iamsurya/MPU6000-Datalogger/Readme.md

Masters Thesis project to create a datalogger that tracks and stores 16 hours of wrist motion data in an effort to create algorithms that can detect eating.

See thesis here: http://cecas.clemson.edu/~ahoover/theses/sharma-thesis.pdf
