iamsurya/MPU6000-Datalogger/Thesis and Presentation/DefensePresentation.pdf

# A device to record natural daily wrist motion

## MS Thesis Defense

Surya Prakash Sharma

Committee Members:
Dr. Adam Hoover (Chair)
Dr. Ian Walker
Dr. Jason Hallstrom

November 24, 2014

# Outline

# - Motivation and Background

# - Methods

# - Results

# - Conclusion

# Motivation

## - Our vision: Wrist-worn eating activity monitor - Previous work: 81% accuracy detecting periods of eating (44 subjects, 1 day) 86% accuracy counting bites during eating (49 subjects, 1 meal) - Need: device to record large number of people for long period of time

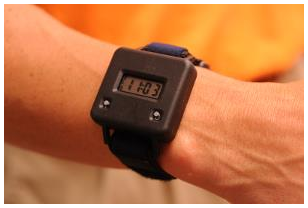
[picture p2: figure]

The bite counter

# Background (cont)

## Recording wrist movement data requires three basic components

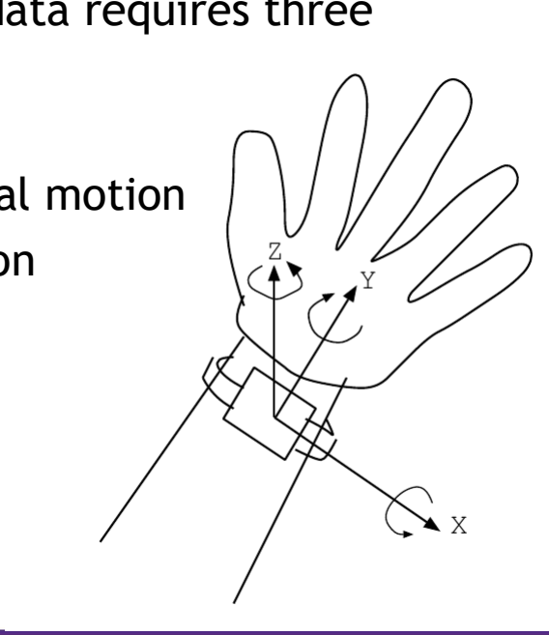
[picture p3: figure]

## Accelerometer – Translational motion Gyroscope – Rotational Motion Memory – Store Data

# Background

## - Multiple wrist worn devices

available.

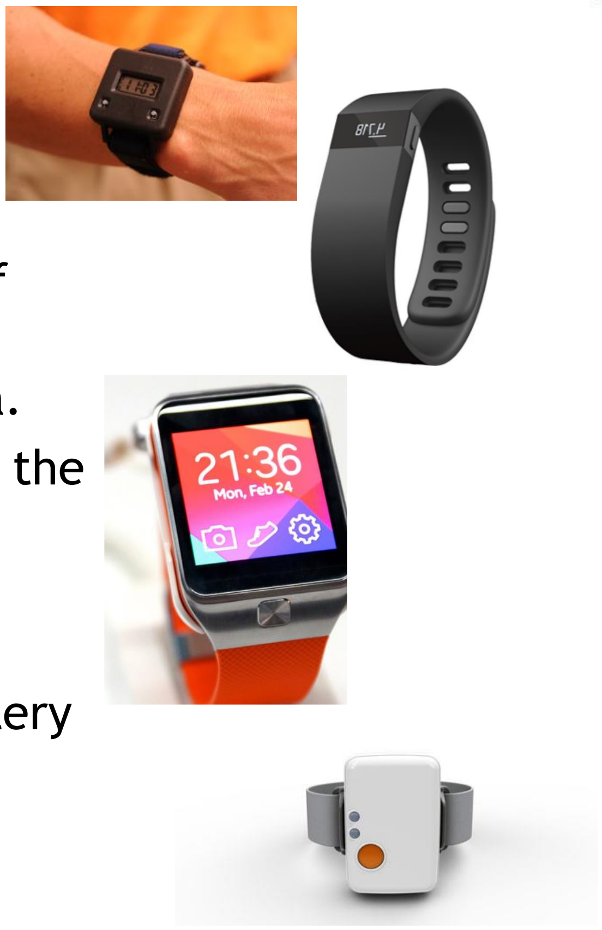
[picture p4: figure]

## - None has addressed the need of recording translational and

rotational wrist movement data.

## - Many devices do not contain all the required sensors - Others have unneeded features increasing cost, weight and discomfort, while reducing battery

life.

# Previous Work

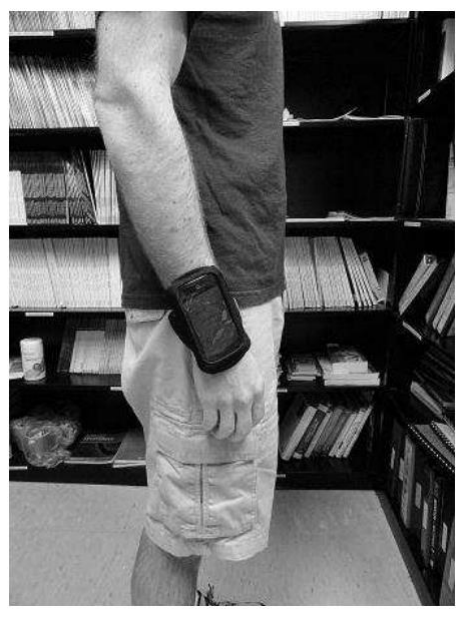
[picture p5: figure]

## - iPhone Based Data Logger

## – Long Battery Life – High resolution data – High customizability

## – Big Size – Low comfort

http://www.ces.clemson.edu/~ahoover/theses/dong-diss.pdf

# Other Devices

## - Activity Trackers

## – Long Battery Life – Small Size – High Comfort – Economical Cost

## – Low resolution data – No customizability – No gyroscope

https://www.flickr.com/photos/uscpsc/13104103473

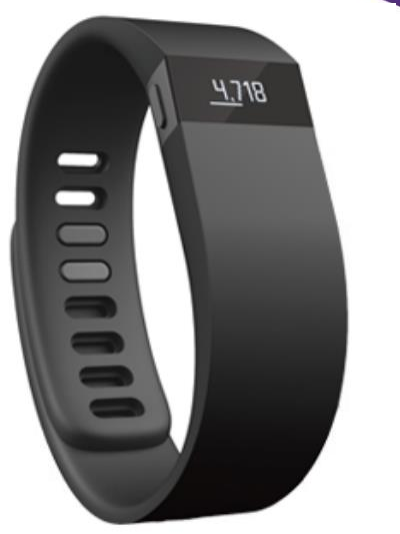
[picture p6: figure]

The Fitbit Flex

# Other Devices (cont)

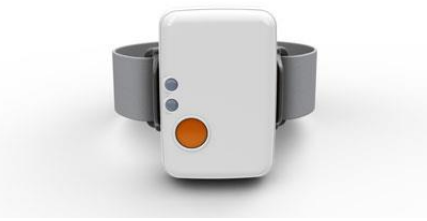
[picture p7: figure]

## - Research Devices

## – Average Battery Life – High resolution Data – High customizability – Medium Comfort

## – High cost – Development Kit: $2000 – Unit : $249

www.shimmersensing.com/shop/shimmer3

Promotional photo of the SHIMMER

# Other Devices (cont)

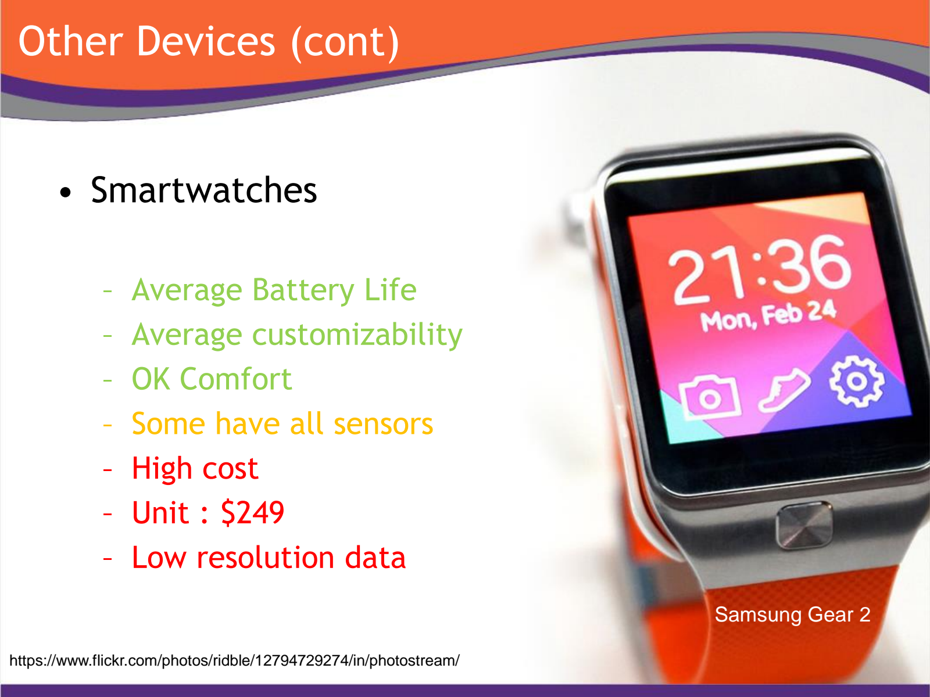
[picture p8: page 9]

## - Smartwatches

## – Average Battery Life – Average customizability – OK Comfort – Some have all sensors – High cost – Unit : $249

## – Low resolution data

https://www.flickr.com/photos/ridble/12794729274/in/photostream/

Samsung Gear 2

# Summary

Name | Market Segments | Both Sensors | Size | Weight (g) | Active Battery Life (hours) | Extra components
iPhone | Mobile Phone | Y | Large | 149 | 40 | Display, GSM Module
MetaWatch | SmartWatch | N | Small | 81 | 80 | Display, Bluetooth Module
Samsung Gear 2 | SmartWatch | Y | Small | 68 | 48 | Display, Bluetooth Module, Media Player
Fitbit Zip | Fitness Tracker | N | Small | 8 | 6 mo
Fitbit Flex | Fitness Tracker | N | Small | N/A | 120
Jawbone Up Move | Fitness Tracker | N | Small | 6.8 | 168
Jawbone Up 3 | Fitness Tracker | N | Small | 29 | 168
Fitbit One | Fitness Tracker | N | Small | 8 | 240
Nike FuelBand | Fitness Tracker | N | Small | 30 | 96
SHIMMER | Research | Y | Medium | 23.6 | 24 | SD Card, Bluetooth Module
Thalmic Labs Myo | Research | Y | Medium | 93 | 48 | EMG Sensors

Note: Sizes are as follows:
Small : Wrist watch or similar
Medium: Larger than wrist watch, smaller than a smartphone. Large: Smartphone

# Novelty

## - New Wrist mounted device to log motion data

## – Good Battery Life – High customizability – Economical Cost – High Comfort

- Smaller size leads to more comfort,

# and the user can wear it longer

# Methods

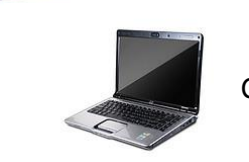
[picture p9: figure]
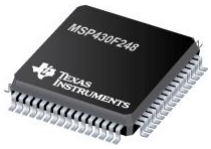
[picture p10: figure]
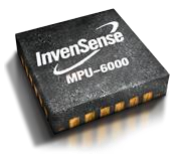
[picture p11: figure]
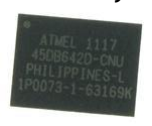
[picture p12: figure]

http://www.ti.com/graphics/folders/partimages/MSP430F248.jpg https://www.flickr.com/photos/40875537@N04/5659910644http://www.snowcap.fi/uploads//2011/12/mpu6000.png (http://www.snowcap.fi/uploads/2011/12/mpu6000.png) http://electronics-diy.com/img/FT232RL_chip.jpghttp://www.mouser.com/images/adestotechnologies/images/cason8.jpg

Sensors

Microcontroller

Memory

USB to UART

Computer

# Components

## •Sensor •Memory chip •Microcontroller •USB to UART bridge •Battery •Battery charger •LED •Button •Case

# Procedure

## •Part selection

## •Circuit design / Prototype / Programming

## •PCB design

## •Soldering

# Sensor

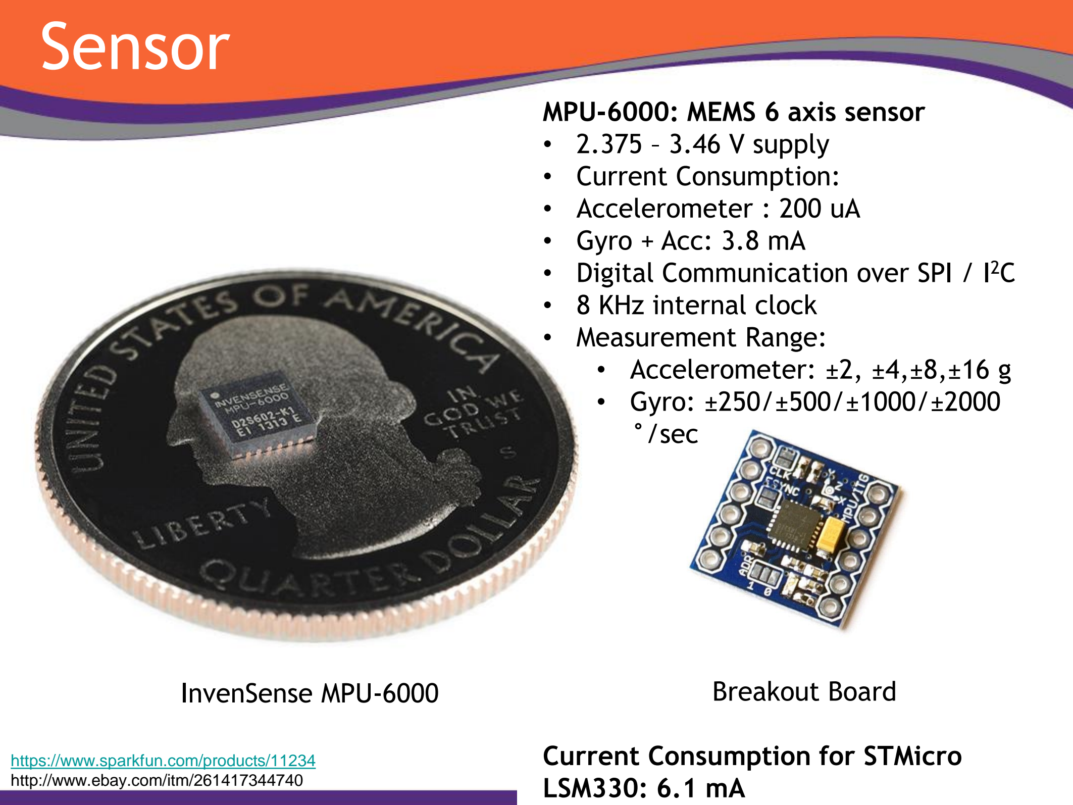
[picture p13: page 15]

MPU-6000: MEMS 6 axis sensor
- 2.375 – 3.46 V supply
- Current Consumption:
- Accelerometer : 200 uA
- Gyro + Acc: 3.8 mA
- Digital Communication over SPI / I²C
- 8 KHz internal clock
- Measurement Range:
- Accelerometer: ±2, ±4,±8,±16 g
- Gyro: ±250/±500/±1000/±2000 °/sec

Breakout Board

Current Consumption for STMicro LSM330: 6.1 mA

InvenSense MPU-6000

https://www.sparkfun.com/products/11234http://www.ebay.com/itm/261417344740

# Microcontroller

MSP430F248

- 1.8 – 3.46 V supply
- Current Consumption : 270 uA @ 1 MHz
- SPI and UART modules
- Two 16 bit timers
- 4 KB RAM

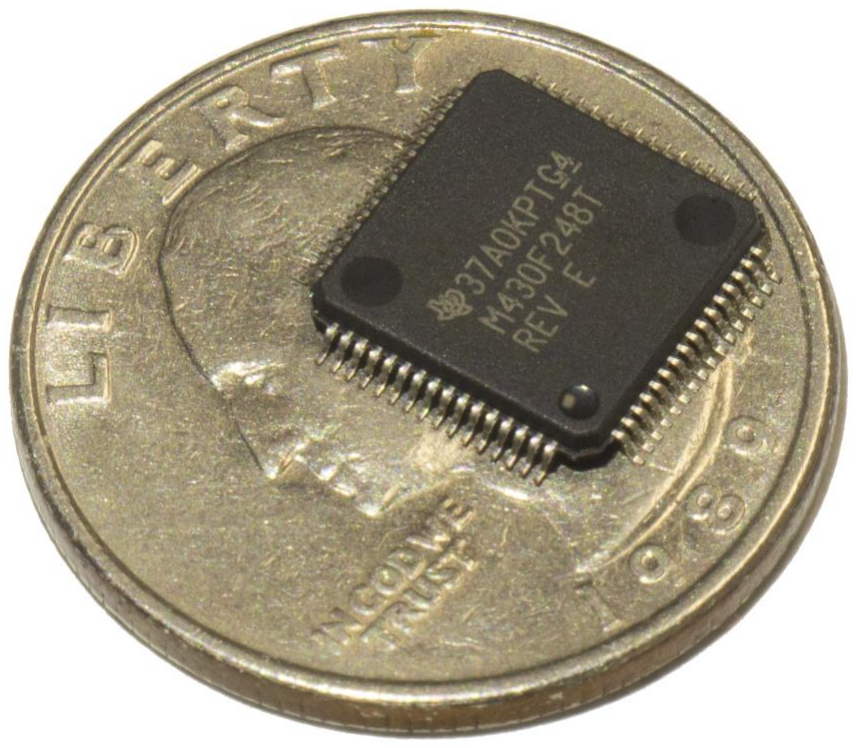
[picture p14: figure]

The MSP430F248 microcontroller

# Memory

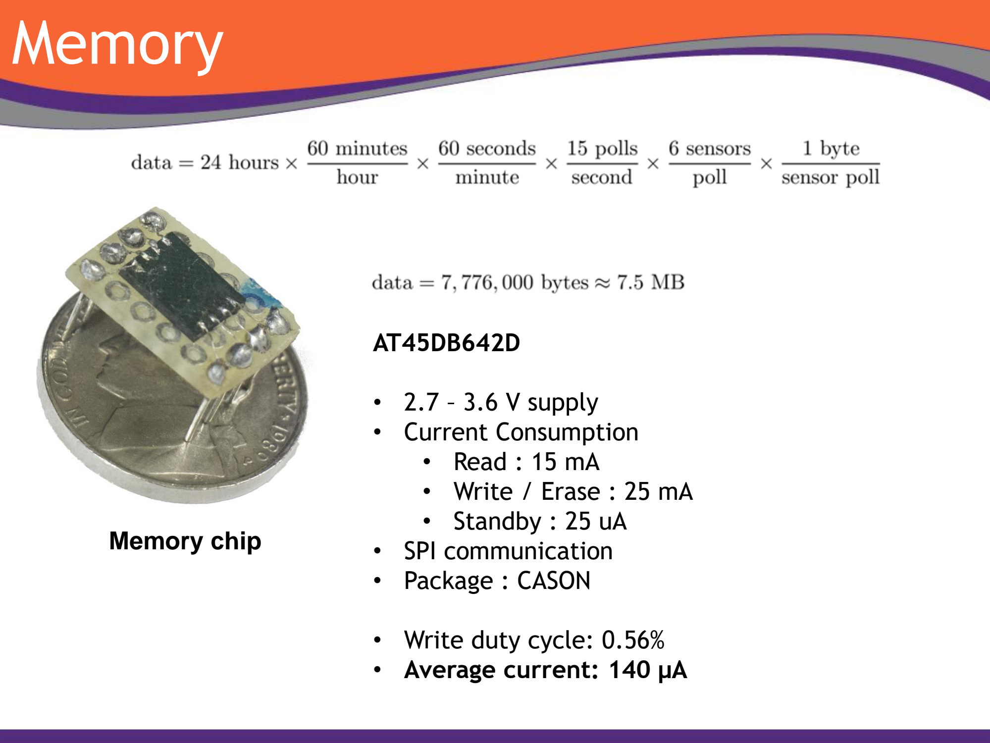
[picture p15: page 17]

AT45DB642D

- 2.7 – 3.6 V supply
- Current Consumption
- Read : 15 mA
- Write / Erase : 25 mA
- Standby : 25 uA
- SPI communication
- Package : CASON
- Write duty cycle: 0.56%
- Average current: 140 μA

Memory chip

# SPI

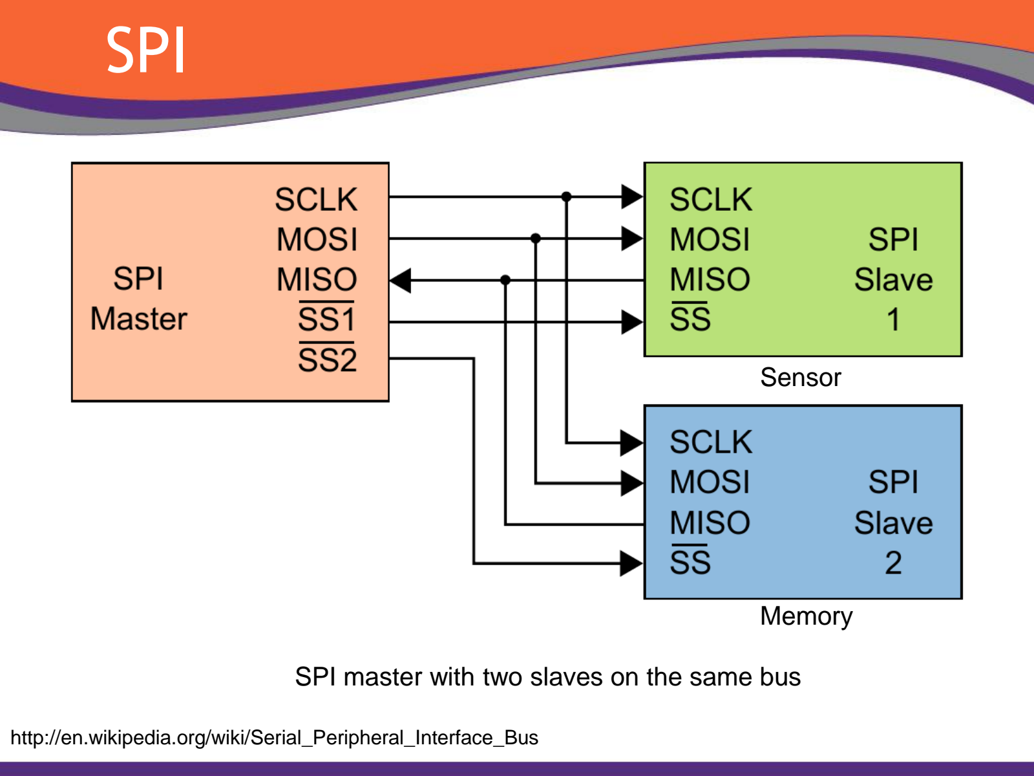
[picture p16: page 18]

SPI master with two slaves on the same bus

Sensor

Memory

http://en.wikipedia.org/wiki/Serial_Peripheral_Interface_Bus

# Data Transfer

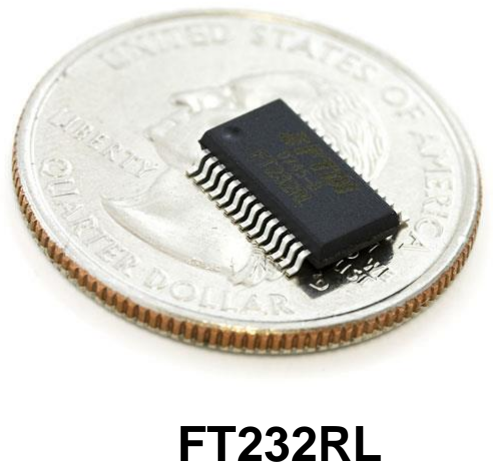
[picture p17: figure]

FT232RL USB to UART bridge

- 5 V supply
- Integrated 3.3 V level converter
- Data transfer technology would require 18 mA of current over 30 minutes
- Using a wired connection allows this power to be sourced from the host
- Battery can be charged with the same connector
- Allows us to get data off the device

https://www.sparkfun.com/products/650

# LED

- Typical current draw of 20 mA
- Duty cycle: 0.56%
- Average current: 110 μA
- Off the shelf LED

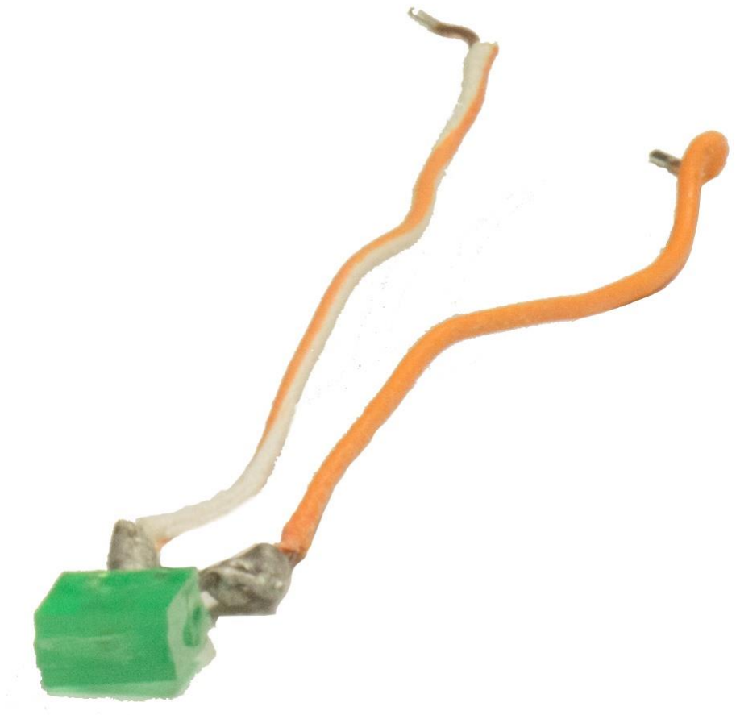
[picture p18: figure]

Photo of a LED

# Case

Ergo Minitec Series

- Largest case used for previous work
- Smallest case measures 52 mm x 32 mm x 15 mm
- Intermediate ring allows a strap to pass through
- Lightweight

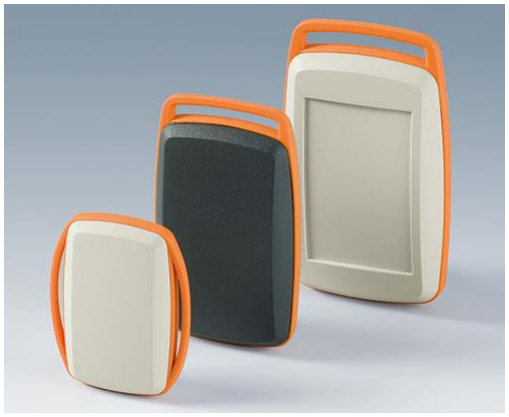
[picture p19: figure]

Ergo Minitec Series Cases

http://www.okw.com/en/Plastic-enclosures/Minitec.htm

# Battery

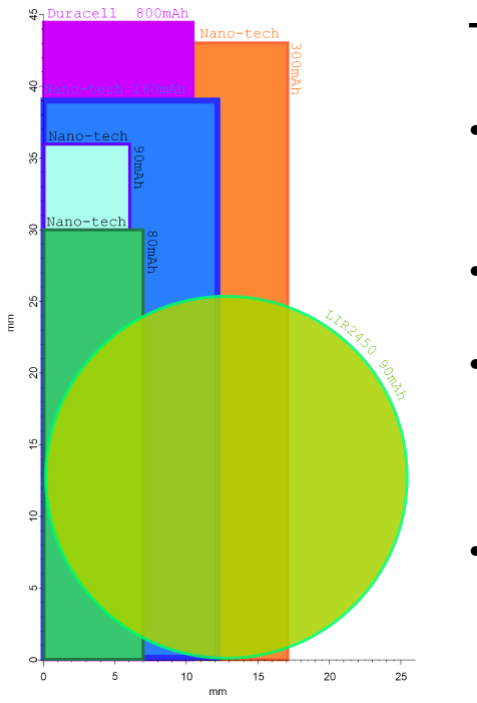
[picture p20: figure]

Top view profiles of different batteries considered

Turnigy Nano-tech 160 mAh

- Most batteries would fit in 52 mm x 32 mm
- Case is limiting factor
- Case is curved so the Duracell AAA 800 mAh, Nano-tech 300 mAh and LIR2450 90 mAh batteries wouldn’t fit
- Nano-tech 160 mAh provides the highest battery capacity

# Prototype

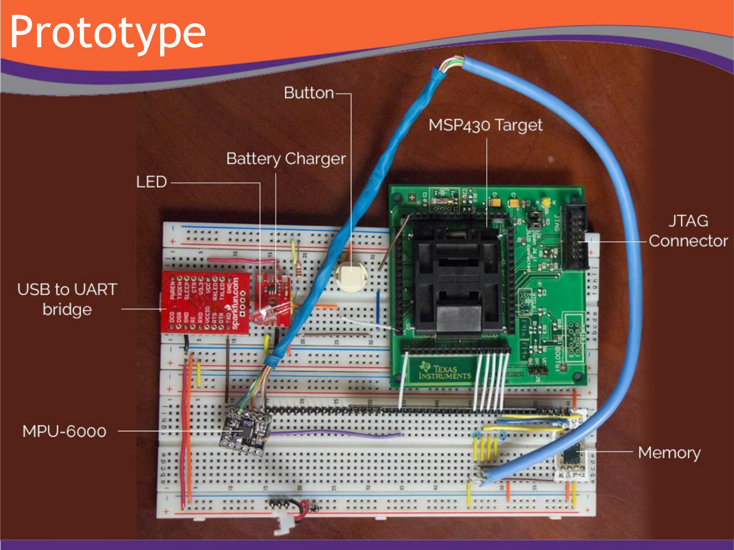
[picture p21: page 23]

# Programming

Simplified algorithm for the device

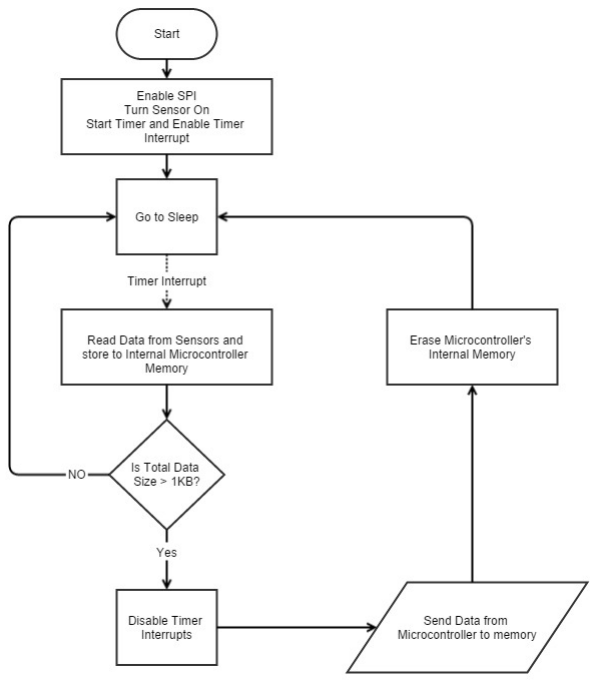
[picture p22: figure]

# PCB Layout

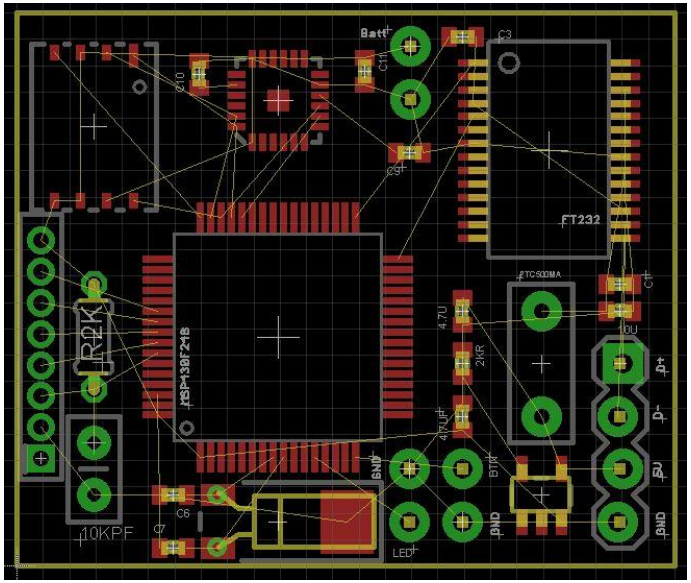
[picture p23: figure]

Parts placed before routing

# PCB Layout (cont)

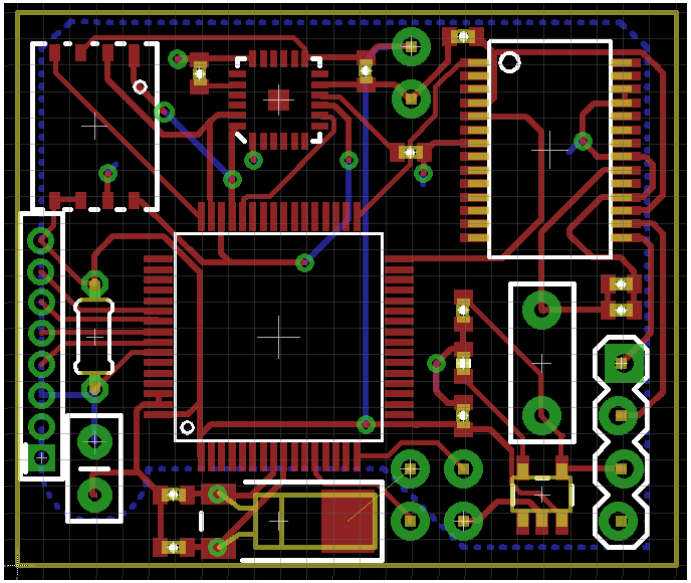
[picture p24: figure]

PCB layout after routing

## Soldering (Mounting Parts)

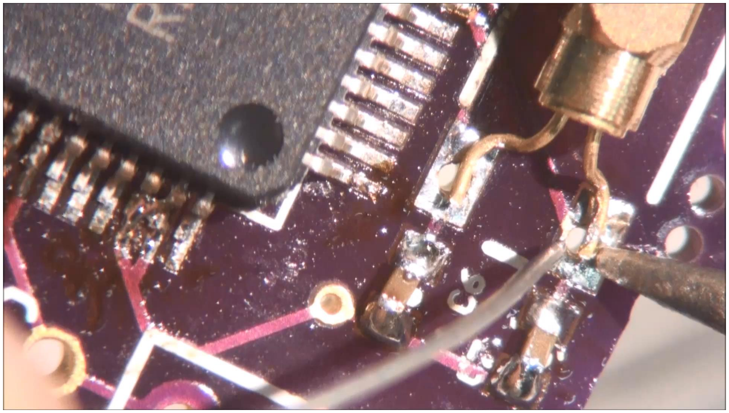
[picture p25: figure]

Video : Soldering Crystal (41 seconds) https://www.youtube.com/watch?v=VSIhrFNCuyM

# Soldering (cont)

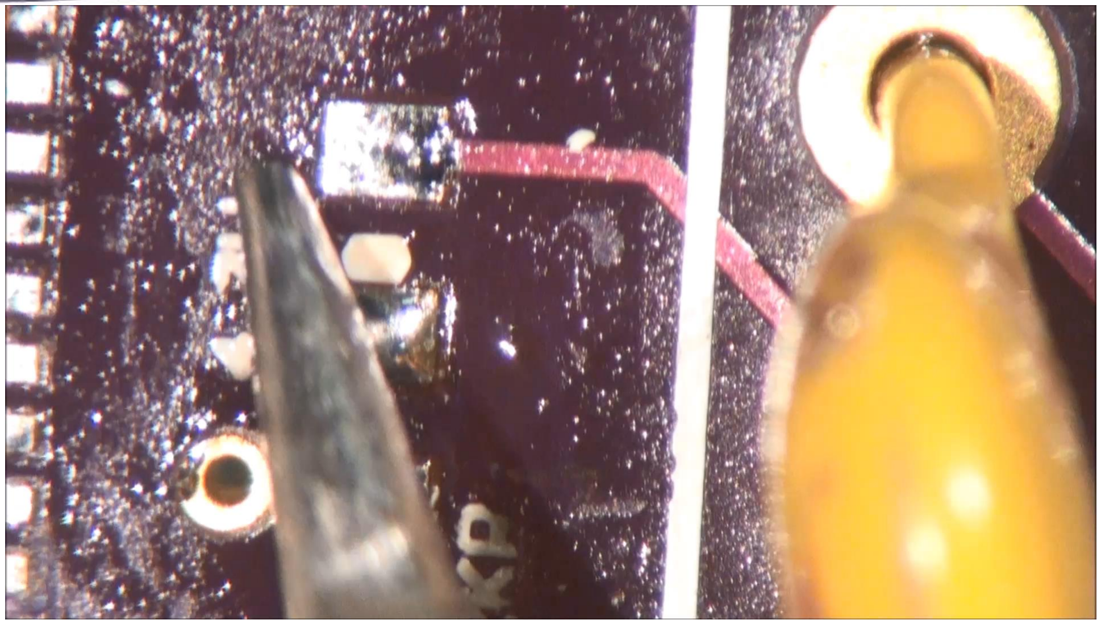
[picture p26: figure]

Video : Soldering SMD Resistor (44 seconds) https://www.youtube.com/watch?v=mzgT1sddoXY

# Z – axis tape

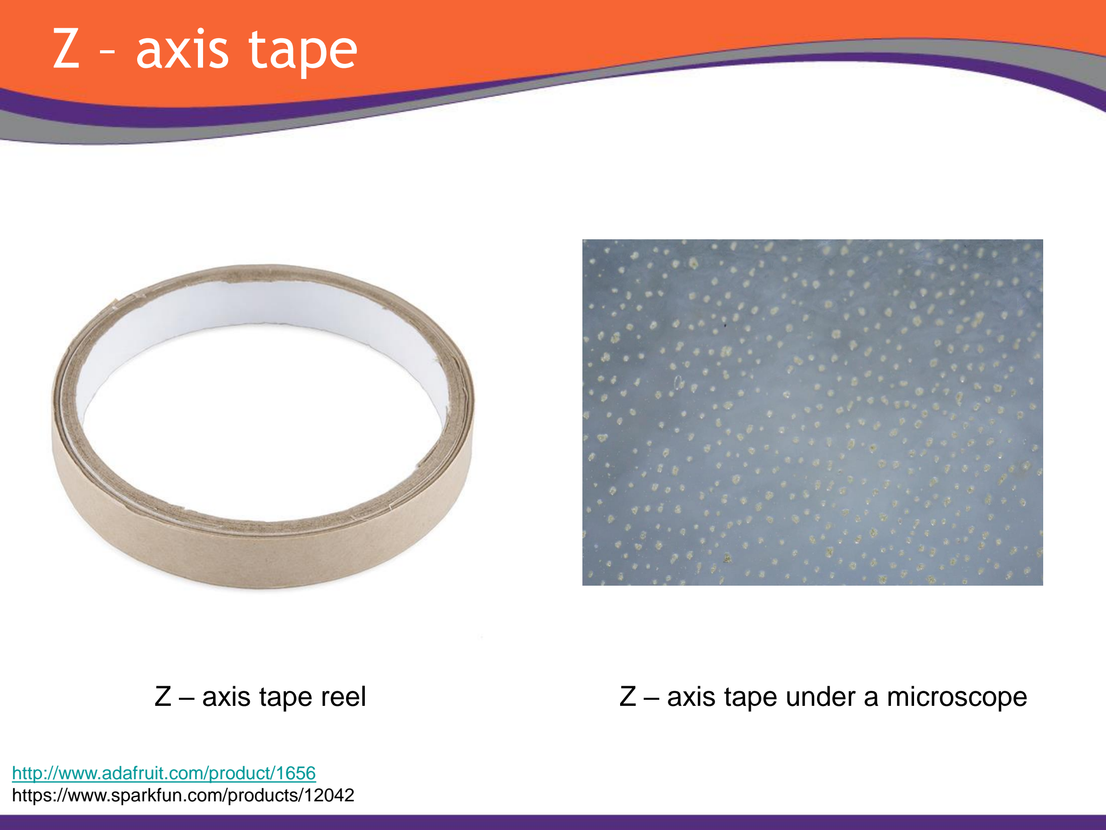
[picture p27: page 29]

Z – axis tape reel | Z – axis tape under a microscope

http://www.adafruit.com/product/1656https://www.sparkfun.com/products/12042

# Soldering (cont)

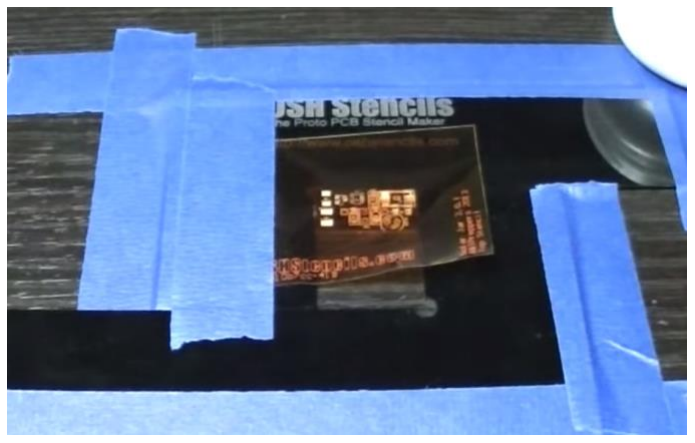
[picture p28: figure]
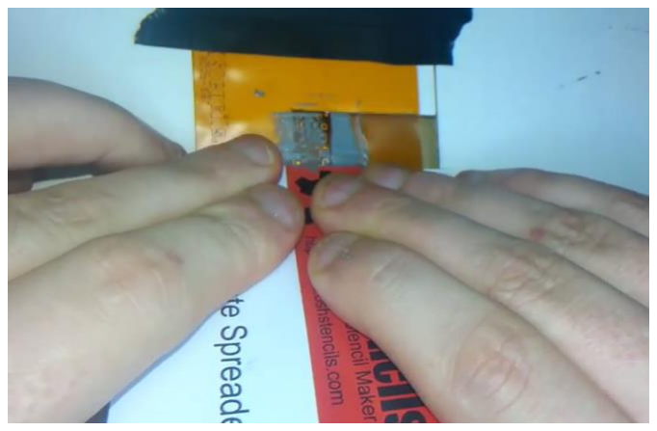
[picture p29: figure]

Stencil placement | Solder paste application

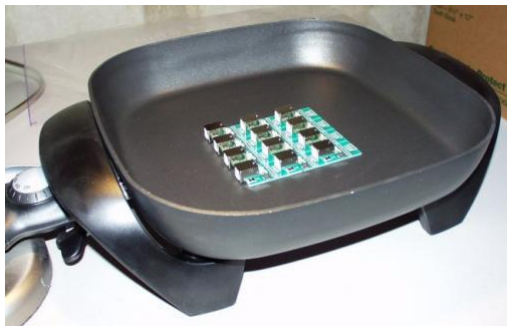
[picture p30: figure]

Hot plate reflow soldering
https://www.sparkfun.com/tutorials/59https://www.youtube.com/watch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

# Final Device

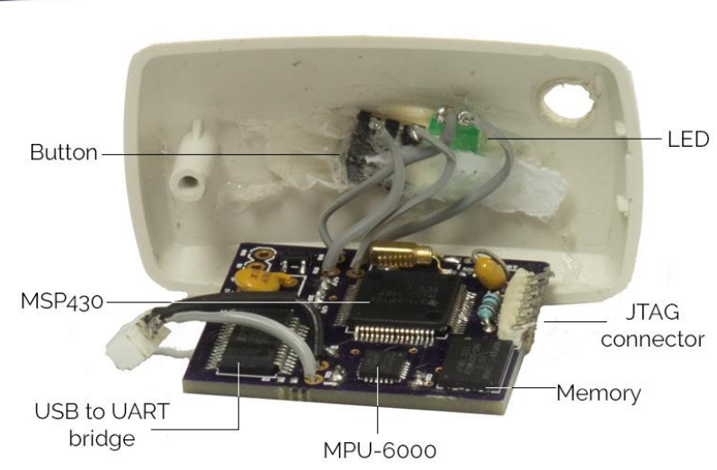
[picture p31: figure]

Final PCB with top case cover

# Results

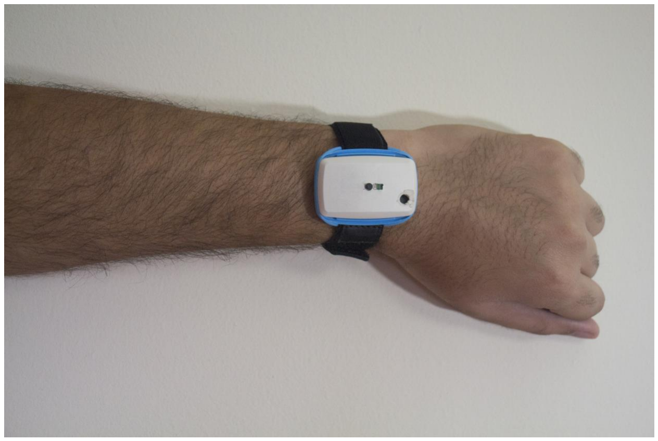
[picture p32: figure]

Final device mounted on wrist

# Results (cont)

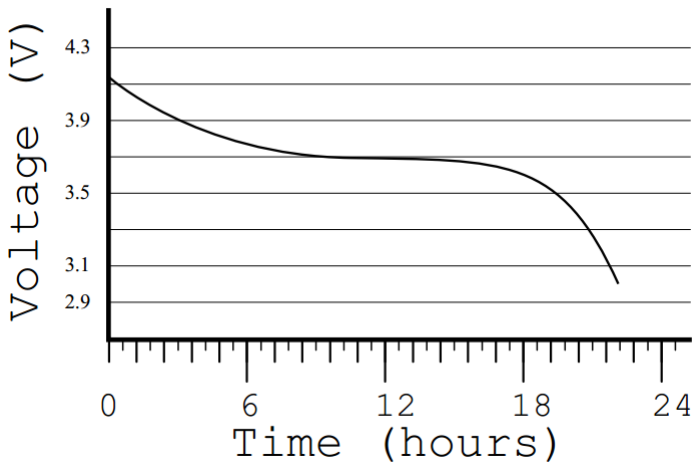
[picture p33: figure]

# Battery life of active device

# Results (cont)

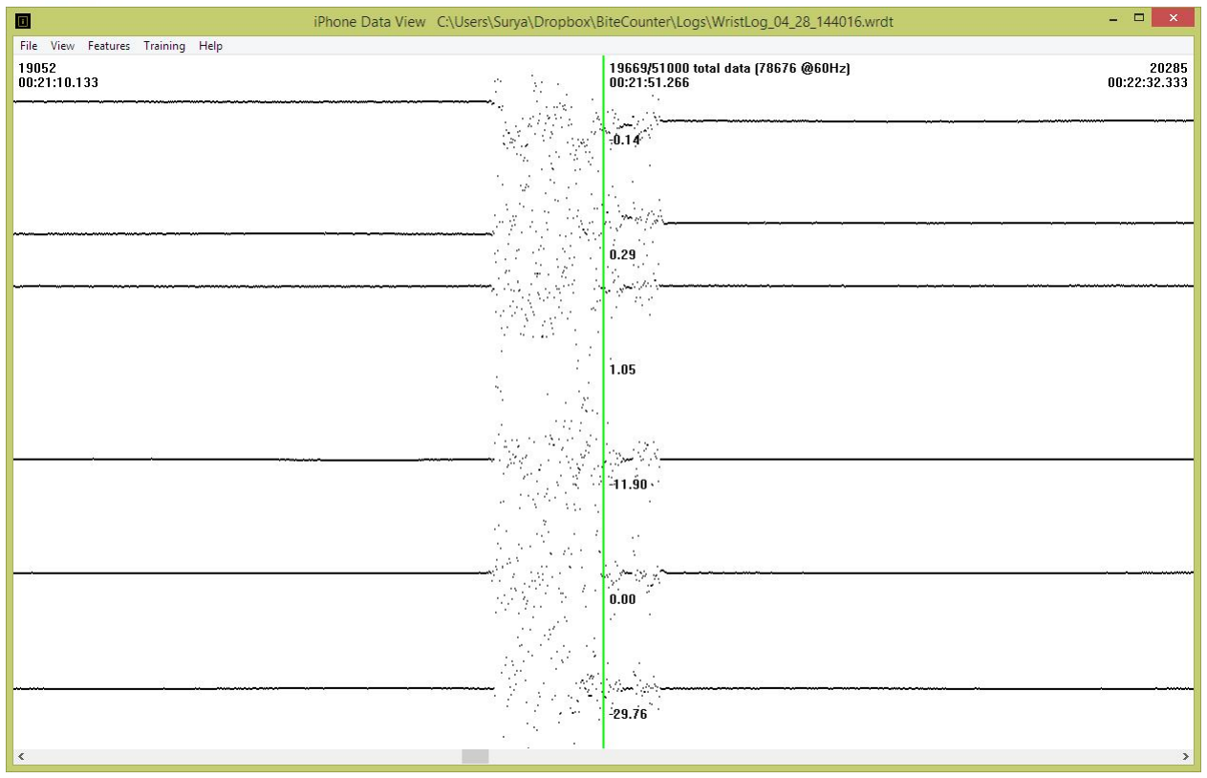
[picture p34: figure]

# WristView showing recorded data

# Results (cont)

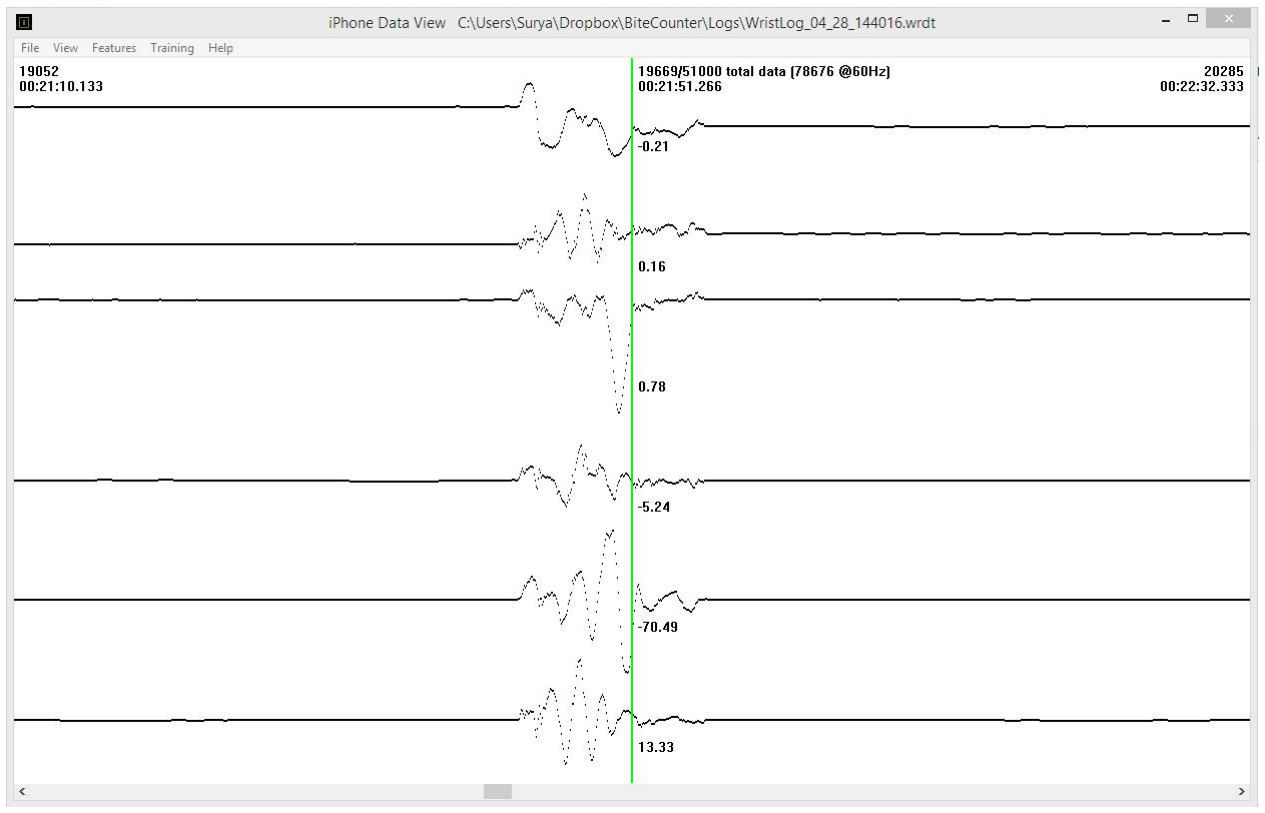
[picture p35: figure]

# WristView showing smoothed data

# Results (cont)

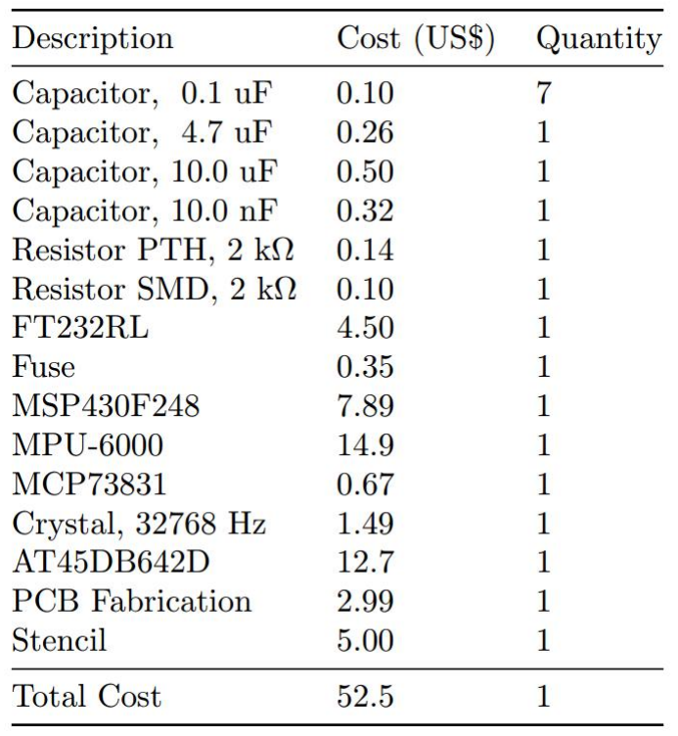
[picture p36: figure]

# Device production cost

# Results (cont)

Name of Device Market Segments | | Both Sensors | Size | Weight | Active Battery Life (hours) | Extra components
iPhone | Mobile Phone | Y | Large | 149 | 40 | Display, GSM Module
MetaWatch | SmartWatch | N | Small | 81 | 80 | Display, Bluetooth Module
Samsung Gear 2 | SmartWatch | Y | Small | 68 | 48 | Display, Bluetooth Module, Media Player
Fitbit Zip | Fitness Tracker | N | Small | 8 | 6 mo
Fitbit Flex | Fitness Tracker | N | Small | N/A | 120
Jawbone Up Move | Fitness Tracker | N | Small | 6.8 | 168
Jawbone Up 3 | Fitness Tracker | N | Small | 29 | 168
Fitbit One | Fitness Tracker | N | Small | 8 | 240
Nike FuelBand | Fitness Tracker | N | Small | 30 | 96
SHIMMER | Research | Y | Medium | 23.6 | 24 | SD Card, Bluetooth Module
Thalmic Labs Myo | Research | Y | Medium | 93 | 48 | EMG Sensors
This Work | Research | Y | Small | 26.6 | 24

## Good Battery Life High customizability Economical Cost High Comfort

# Challenges

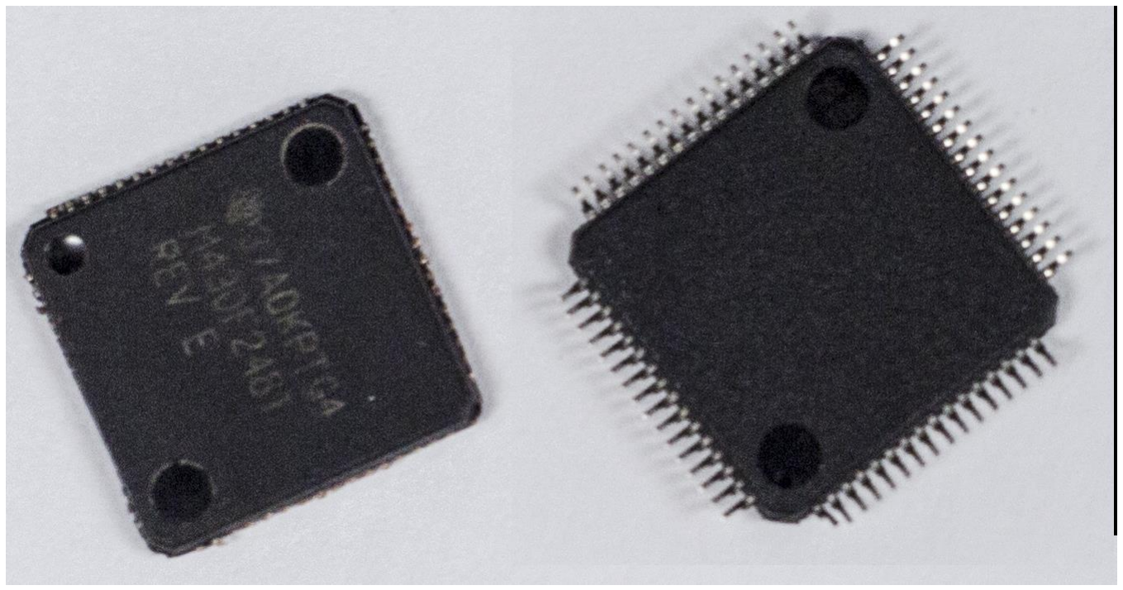
[picture p37: figure]

Microcontroller after cutting pins to desolder

# Future Work

## - Dataset of wrist motion movement needs to be created

## - 100 – 200 subjects wearing this device for up to 2 weeks each

## - 20 – 25 devices needed

## Future Work (cont)

## - Add a local time feature to the watch

## - Consider using EMG sensors to pursue new algorithms

## - Try a different profile with custom molded case

# Questions ?

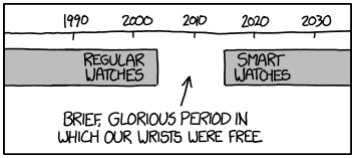
[picture p38: figure]

Old people used to write obnoxious thinkpieces about how people these days always wear watches and are slaves to the clock, but now they've switched to writing thinkpieces about how kids these days don't appreciate the benefits of an old-fashioned watch. My position is: The word 'thinkpiece' sounds like a word made up by someone who didn't know about the word 'brain'.

http://xkcd.com/1420/
