iamsurya/MPU6000-Datalogger/PCB Layout/BC7.PNG

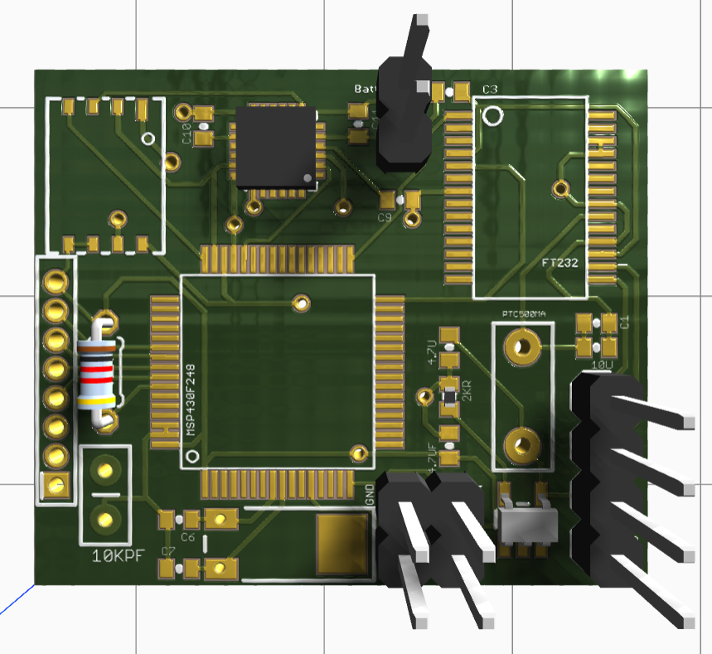
PCB Layout/BC7.PNG
