iamsurya/MPU6000-Datalogger/Datasheets/BOM.xlsx

Sheet: BC52
Part | Value | Device | Package | Description | DATASHEET | LINK | MFGPN | PROD_ID
2KR | 2k | RESISTOR0402-RES | 0402-RES | Resistor
R2K | 2k | R-US_0204/5 | 0204/5 | RESISTOR, American symbol
4.7U | 4.7u | CAP0402-CAP | 0402-CAP | Capacitor
4.7UF | 4.7u | CAP0402-CAP | 0402-CAP | Capacitor
10KPF | 10000pf | CAPEZ | CAP-PTH-SMALLEZ | Capacitor
10U | 10u | CAP0402-CAP | 0402-CAP | Capacitor
C1 | 0.1u | CAP0402-CAP | 0402-CAP | Capacitor
C3 | 0.1u | CAP0402-CAP | 0402-CAP | Capacitor
C6 | 0.1u | CAP0402-CAP | 0402-CAP | Capacitor
C7 | 0.1u | CAP0402-CAP | 0402-CAP | Capacitor
C9 | 0.1u | CAP0402-CAP | 0402-CAP | Capacitor
C10 | 0.1u | CAP0402-CAP | 0402-CAP | Capacitor
C11 | 0.1u | CAP0402-CAP | 0402-CAP | Capacitor
PTC500MA | PTCPTH | PTCPTH | PTC | Resettable Fuse PTC
Q1 |  | 32768Hz Crystal | MS1V-T1K | p r e l i m i n a r y 5 . 0 . 0
U$3 | MPU-6000 | MPU-6000 | QFN-24 | Invensense MPU-6000: 3-axis gyro, 3-axis accel & 9-axis MotionFusion | http://invensense.com/mems/gyro/documents/PS-MPU-6000A-00_v1.0.pdf | http://invensense.com/mems/gyro/mpu6000.html | MPU-6000
U1 | FT232R | FT232RLSSOP | SSOP28DB | USB UART
U2 | MCP73831 | MCP73831 | SOT23-5 | Miniature single cell, fully integrated Li-Ion, Li-polymer charge management controller |  |  |  | IC-09995
U3 | AT45DB642DCASON8 | AT45DB642DCASON8 | CASON8 | at45db642d memory CASON8
UC | MSP430F248 | MSP430F248 F24[X/10]---PM64 | PM/PAG64 | ***MSP430F24[x/10]***PM64
BATT | M021X02_NO_SILK | M021X02_NO_SILK | 1X02_NO_SILK | Standard 2-pin 0.1 header. Use with"
BTN | M021X02_NO_SILK | M021X02_NO_SILK | 1X02_NO_SILK | Standard 2-pin 0.1 header. Use with"
JP1 |  | M04LOCK | 1X04_LOCK | Header 4
LED | M021X02_NO_SILK | M021X02_NO_SILK | 1X02_NO_SILK | Standard 2-pin 0.1 header. Use with"
U$2 | AVR_MINI_PROGSMD | AVR_MINI_PROGSMD | AVR_MINI_PROG | AVR ISP 6-pin inline header

Sheet: Sheet1
0.1uF 0402 | 587-1227-1-ND | http://www.digikey.com/product-detail/en/LMK105BJ104KV-F/587-1227-1-ND/931004 | 0.1 | 7
4.7uF 0402 | 712-1166-1-ND | http://www.digikey.com/product-detail/en/500R07S4R7BV4T/712-1166-1-ND/1786628 | 0.26 | 2
10u 0402 | 445-8919-1-ND | http://www.digikey.com/product-detail/en/C1005X5R0G106M050BB/445-8919-1-ND/3507810 | 0.5 | 1
10000pf | 1103PHCT-ND | http://www.digikey.com/product-detail/en/A103K15X7RF5TAA/1103PHCT-ND/145937 | 0.32 | 1
2k Ohms PTH | S2KCACT-ND | http://www.digikey.com/product-detail/en/RNMF14FTC2K00/S2KCACT-ND/2617814 | 0.14 | 1
2k Ohms 0402 | 311-1.0KJRCT-ND | http://www.digikey.com/product-detail/en/RC0402JR-071KL/311-1.0KJRCT-ND/729355 | 0.1 | 1
FT232RL | 768-1007-1-ND | http://www.digikey.com/product-detail/en/FT232RL-REEL/768-1007-1-ND/1836402 | 4.5 | 1
MSP430F248 | 296-22893-1-ND | http://www.digikey.com/product-detail/en/MSP430F248TPMR/296-22893-1-ND/1765790 | 7.89 | 1
MPU6000 | 1428-1005-1-ND | http://www.digikey.com/product-detail/en/MPU-6000/1428-1005-1-ND/4038006 | 14.89 | 1
PTC Fuse | A85432-000-ND | http://www.digikey.com/product-detail/en/A85432-000/A85432-000-ND/1045823 | 0.35 | 1
Charging IC | MCP73831T-2ACI/OTCT-ND | http://www.digikey.com/product-detail/en/MCP73831T-2ACI%2FOT/MCP73831T-2ACI%2FOTCT-ND/1979802 | 0.67 | 1
32768Mhz Crystal |  | http://www.newark.com/micro-crystal/ms1v-t1k-32-768khz-20ppm-12/crystal-32-768khz-12-5pf-smd-met/dp/94M8459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 | 1.49 | 1
Memory Chip | EOL | EOL | EOL | 1
 |  |  |  | 20
