iamsurya/MPU6000-Datalogger/Datasheets/SensorComparison.xlsx

Name | Description | Analog / Digital | Package | Current Consumption | Noise | Full Scale Range (degrees/sec) | Connections
LPR410AL | 2 Axis Gyro (pitch, roll) | Analog | LGA 4X5X1.1mm | 6.8mA | 0.014 (°/s/ √ Hz) | 100
LPY410AL | 2 Axis Gyro (pitch, yaw) | Analog | LGA 4X5X1.1mm | 6.8mA | 0.014 (°/s/ √ Hz) | 100
LPR344ALH | 3 Axis Accelerometer (X,Y,Z) | Analog | LGA 4X4X1.5mm | 680uA(typ) 850uA(max) | 50 (ug/ √ Hz) | +-2 / +-6
LGD20H Series | 3 Axis Gyro (y,p,r) | Digital | LGA 3X3X1.1mm | 6.1 - 6.4mA | 0.03 (°/s/ √ Hz) | ±245/±500/±2000 dps | 1 cap, (+2 I2C) (+4SPI)
L3G462A | 3 Axis Gyro (y,p,r) | Analog | LGA 4X4X1.1mm | 6.9mA | 0.17 (°/s/ √ Hz) | 625dps | 1 cap, +3 OP (+2 Mode Select) | Evaluation
LSM330 | 6 Axis (X,Y,Z,y,p,r) | Digital | TFLGA 3.5X3X1mm | 6.1mA | (0.03?) | [±2 g/±4 g/±6 g/±8 g/±16 g] [±250/±500/±2000]
Invensense MPU-61NX | 6 Axis | Digital | QFN (4X4X0.9) | Gyro + Accel operating current: 3.8mA (full power, gyro at all rates, accel at 1kHz sample rate) | 0.005°/√Hz | [±2g, ±4g, ±8g,±16g][±56 ± 113 ± 225 ± 450] |  | Sample to select customers in Q3 2013.
Invensense MPU-6X50 | 6 Axis | Digital (I2C,SPI) | QFN (4X4X0.9) | Gyro + Accel operating current: 3.8mA (full power, gyro at all rates, accel at 1kHz sample rate) | 0.005°/√Hz | [±2g, ±4g, ±8g,±16g][±250, ±500, ±1000, and ±2000°/sec] |  | Available
Invensense MPU-91NX | 9 Axis (6 Axis + magnetometer) | Digital | QFN (4x4x1mm) | Gyro + Accel operating current: 3.8mA (full power, gyro at all rates, accel at 1kHz sample rate) |  | [±2g, ±4g, ±8g,±16g][±250, ±500, ±1000, and ±2000°/sec] |  | Available
Accel low power mode operating current: 10uA at 1Hz, 20uA at 5Hz, 70uA at 20Hz, 140uA at 40Hz | Full Chip Idle Mode Supply Current: 8µA
