iamsurya/MPU6000-Datalogger/Datasheets/SensorsfromSTM.xlsx

Part Number | Marketing Status | Package | Sensing Axes | Angular Rate Range(FS) typ () | Output Type | Supply Voltage(VDD) min (V) | Supply Voltage(VDD) typ (V) | Supply Voltage(VDD) max (V) | Angular Rate Noise Density(Rn) typ (°/s/ √ Hz) | Current Consumption typ (mA) | Current Consumption (Low Power Mode) typ (mA) | Current Consumption (Power Down Mode) typ (mA) | General Description
LPR410AL | Active | LGA 28 4x5x1.1 | pitch, roll | 100 | Analog | 2.7 | 3 | 3.6 | 0.014 | 6.8 | 2.1 | 0.001 | -
LPY410AL | Active | LGA 28 4x5x1.1 | pitch, yaw | 100 | Analog | 2.7 | 3 | 3.6 | 0.014 | 6.8 | 2.1 | 0.001 | -
A3G4250D | Active | LGA 16 4x4x1.1 | yaw, pitch, roll | 245 | Digital | 2.4 | 3 | 3.6 | 0.03 | 6.1 | 1.5 | 0.005 | MEMS motion sensor: 3-axis digital output gyroscope
L2G3IS | Preview | TFLGA 3.5X3X1 16L PITCH 0.5 | pitch, roll | - | Digital | 2.42 | 3.3 | 3.6 | - | 6.4 | 2.5 | 0.02 | MEMS motion sensor: two-axis digital output gyroscope for optical image stabilization
L3G3200D | Active | TFLGA 3X3.5X1 16L | yaw, pitch, roll | 2000 | Digital | 2.4 | 3 | 3.6 | 0.03 | 6.1 | 2 | 0.005 | MEMS motion sensor: 3-axis digital gyroscope
L3G3250A | Preview | TFLGA 3X3.5X1 16L | yaw, pitch, roll | 2000 | Analog | 2.4 | 3 | 3.6 | 0.015 | 6.3 | 2 | 0.005 | MEMS motion sensor: 3-axis nano analog gyroscope
L3G3IS | Preview | TFLGA 3.5X3X1 16L PITCH 0.5 | yaw, pitch, roll | - | Digital | 2.42 | 3.3 | 3.6 | - | 6.4 | 2.5 | 0.02 | MEMS motion sensor: three-axis digital output gyroscope for optical image stabilization
L3G4200D | Active | LGA 16 4x4x1.1 | yaw, pitch, roll | 2000 | Digital | 2.4 | 3 | 3.6 | 0.03 | 6.1 | 1.5 | 0.005 | MEMS motion sensor: three-axis digital output gyroscope
L3G462A | Evaluation | LGA 16 4x4x1.1 | yaw, pitch, roll | 625 | Analog | 2.4 | 3 | 3.6 | 0.017 | 6.9 | 2 | 0.005 | MEMS motion sensor ± 625 dps full scale 3-axis analog gyroscope
L3G4IS | Active | LGA 16 4x4x1.0 | yaw, pitch, roll | - | Digital | 2.4 | 2.8 | 3.6 | - | - | - | 0.02 | MEMS motion sensor: three-axis digital output gyroscope for gaming and OIS
L3GD20 | Active | LGA 16 4x4x1.0 | yaw, pitch, roll | - | Digital | 2.4 | 3 | 3.6 | - | 6.1 | 2 | 0.005 | MEMS motion sensor: 3-axis digital gyroscope
L3GD20H | Active | LLGA 16 3x3x1.0 | yaw, pitch, roll | 2000 | Digital | 2.2 | 3 | 3.6 | 0.011 | 6.1 | 2.5 | 1 | MEMS motion sensor: 3-axis digital output gyroscope
LPR403AL | Active | LGA 28 4x5x1.1 | pitch, roll | 30 | Analog | 2.7 | 3 | 3.6 | 0.01 | 6.8 | 2.1 | 0.001 | -
LPR4150AL | Active | LGA 28 4x5x1.1 | pitch, roll | 1500 | Analog | 2.7 | 3 | 3.6 | 0.075 | 6.8 | 2.1 | 0.001 | -
LPR430AL | Active | LGA 28 4x5x1.1 | pitch, roll | 300 | Analog | 2.7 | 3 | 3.6 | 0.018 | 6.8 | 2.1 | 0.001 | -
LPR450AL | Active | LGA 28 4x5x1.1 | pitch, roll | 500 | Analog | 2.7 | 3 | 3.6 | 0.025 | 6.8 | 2.1 | 0.001 | -
LPY403AL | Active | LGA 28 4x5x1.1 | pitch, yaw | 30 | Analog | 2.7 | 3 | 3.6 | 0.01 | 6.8 | 2.1 | 0.001 | -
LPY4150AL | Active | LGA 28 4x5x1.1 | pitch, yaw | 1500 | Analog | 2.7 | 3 | 3.6 | 0.075 | 6.8 | 2.1 | 0.001 | -
LPY430AL | Active | LGA 28 4x5x1.1 | pitch, yaw | 300 | Analog | 2.7 | 3 | 3.6 | 0.018 | 6.8 | 2.1 | 0.001 | -
LPY450AL | Active | LGA 28 4x5x1.1 | pitch, yaw | 500 | Analog | 2.7 | 3 | 3.6 | 0.025 | 6.8 | 2.1 | 0.001 | -
LY3100ALH | Active | LGA 10 3x5x1.1 | yaw | 1000 | Analog | 2.7 | 3 | 3.6 | 0.016 | 4.2 | 2.2 | 0.005 | -
LY3200ALH | Active | LGA 10 3x5x1.1 | yaw | 2000 | Analog | 2.7 | 3 | 3.6 | 0.074 | 4.2 | 2.2 | 0.005 | -
LY330ALH | Active | LGA 10 3x5x1.1 | yaw | 300 | Analog | 2.7 | 3 | 3.6 | 0.014 | 4.2 | 2.2 | 0.005 | -
