iamsurya/MPU6000-Datalogger/PCB Layout/BC7.brd

## EAGLE design PCB Layout/BC7.brd (2018-02-04)

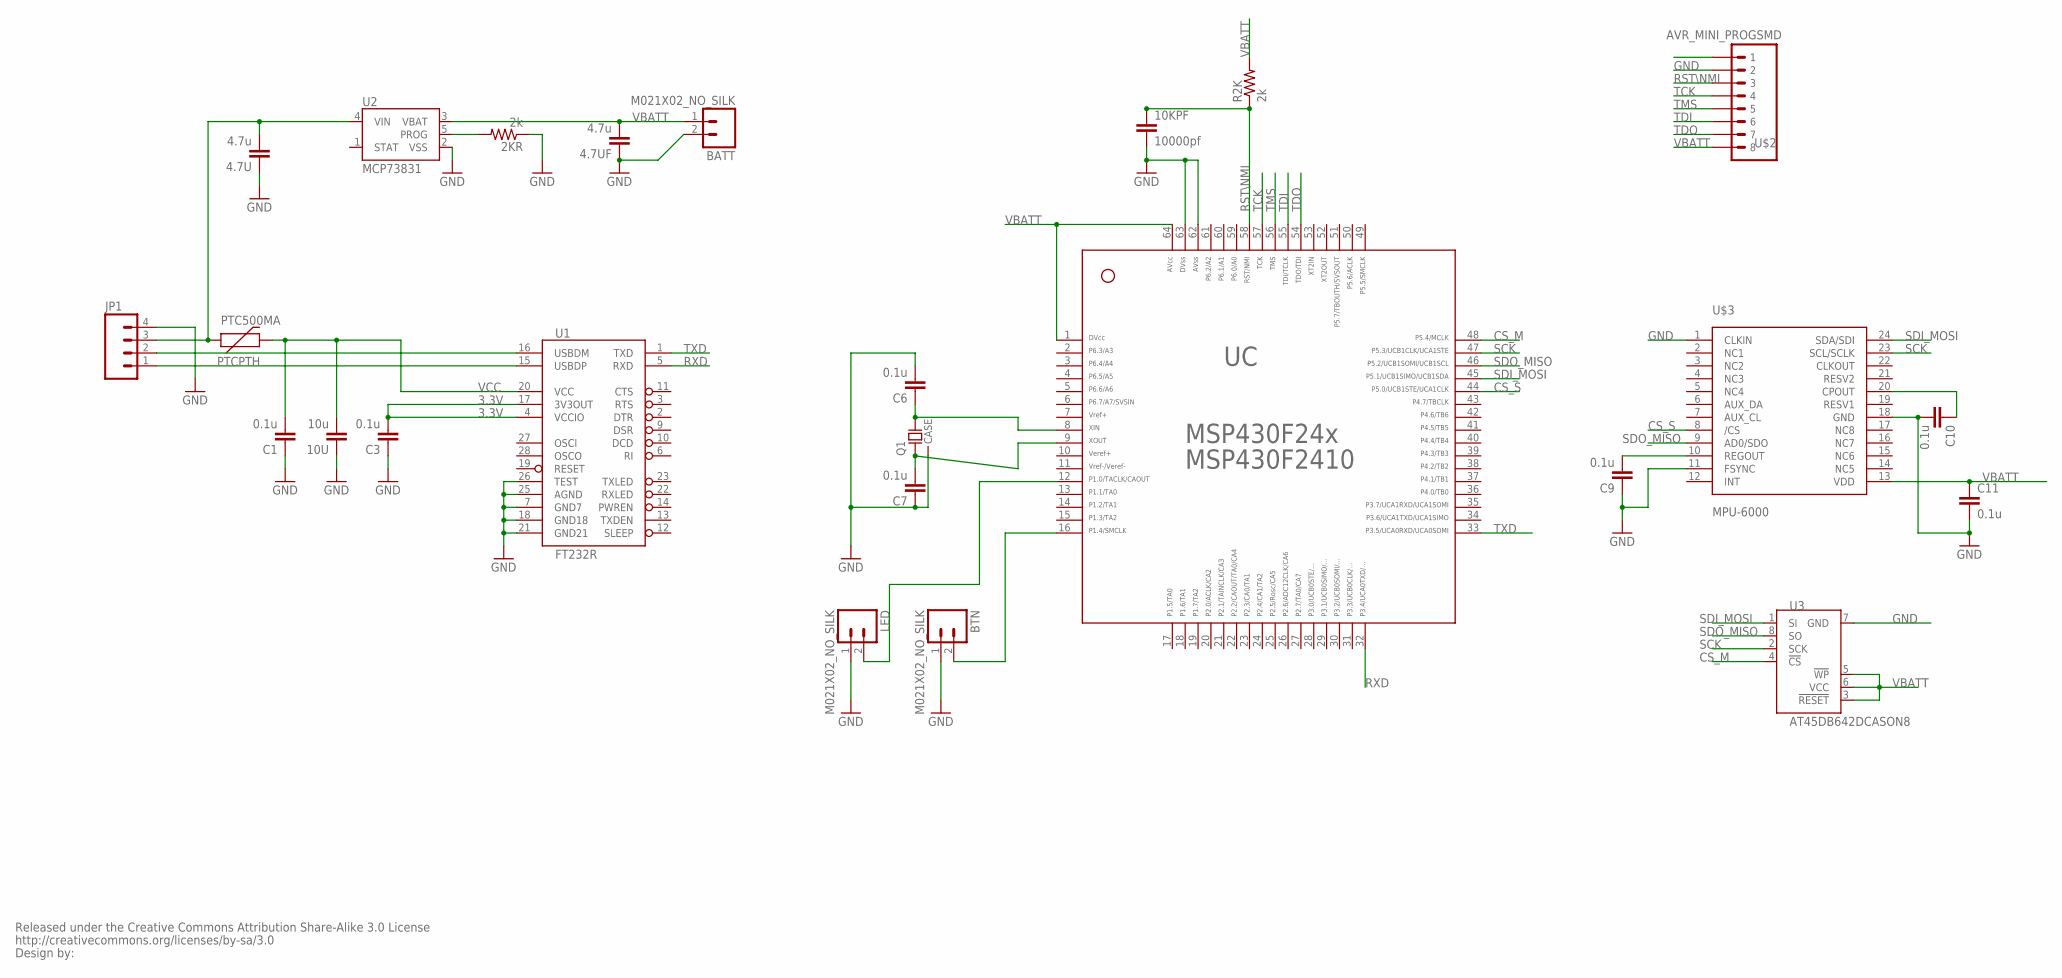
[picture p40: schematic BC7.sch]

Parts:
2KR: 2k; 0402-RES
4.7U, 4.7UF: 4.7u; 0402-CAP
10KPF: 10000pf; CAP-PTH-SMALLEZ
10U: 10u; 0402-CAP
BATT: M021X02_NO_SILK; 1X02_NO_SILK
BTN: M021X02_NO_SILK; 1X02_NO_SILK
C1, C3, C6, C7, C9, C10, C11: 0.1u; 0402-CAP
JP1: M04LOCK; 1X04_LOCK
LED: M021X02_NO_SILK; 1X02_NO_SILK
PTC500MA: PTCPTH; PTC
Q1: MS1V-T1K-32.768KHZ/12.5PF/20PPM/TA/QC; MS1V-T1K
R2K: 2k; 0204/5
U1: FT232R; SSOP28DB
U2: MCP73831; SOT23-5
U3: AT45DB642DCASON8; CASON8
U$1: CREATIVE_COMMONS
U$2: AVR_MINI_PROGSMD; AVR_MINI_PROG
U$3: MPU-6000; QFN-24
UC: F24[X/10]---PM64; PM/PAG64

Connections:
3.3V: C3.2, U1.4 (VCCIO), U1.17 (3V3OUT)
5V: 4.7U.2, JP1.3, PTC500MA.P$1 (1), U2.4 (VIN)
BTN: BTN.2, UC.16
CS_M: U3.4 (!CS), UC.48
CS_S: U$3.8 (/CS), UC.44
GND: 2KR.1, 4.7U.1, 4.7UF.1, 10KPF.2, 10U.1, BATT.2, BTN.1, C1.1, C3.1, C6.2, C7.1, C9.1, C10.2, C11.2, JP1.4, LED.1, Q1.CASE, U1.7 (GND7), U1.18 (GND18), U1.21 (GND21), U1.25 (AGND), U1.26 (TEST), U2.2 (VSS), U3.7 (GND), U$2.2, U$3.1 (CLKIN), U$3.11 (FSYNC), U$3.18 (GND), UC.62, UC.63
unnamed: LED.2, UC.12
unnamed: 2KR.2, U2.5 (PROG)
unnamed: C6.1, Q1.2, UC.8
unnamed: C7.2, Q1.1, UC.9
unnamed: C9.2, U$3.10 (REGOUT)
unnamed: C10.1, U$3.20 (CPOUT)
RST\NMI: 10KPF.1, R2K.1, U$2.3, UC.58
RXD: U1.5 (RXD), UC.32
SCK: U3.2 (SCK), U$3.23 (SCL/SCLK), UC.47
SDI_MOSI: U3.1 (SI), U$3.24 (SDA/SDI), UC.45
SDO_MISO: U3.8 (SO), U$3.9 (AD0/SDO), UC.46
TCK: U$2.4, UC.57
TDI: U$2.6, UC.55
TDO: U$2.7, UC.54
TMS: U$2.5, UC.56
TXD: U1.1 (TXD), UC.33
USB_D+: JP1.1, U1.15 (USBDP)
USB_D-: JP1.2, U1.16 (USBDM)
VBATT: 4.7UF.2, BATT.1, C11.1, R2K.2, U2.3 (VBAT), U3.3 (!RESET), U3.5 (!WP), U3.6 (VCC), U$2.8, U$3.13 (VDD), UC.1, UC.64
VCC: 10U.2, C1.2, PTC500MA.P$2 (2), U1.20 (VCC)

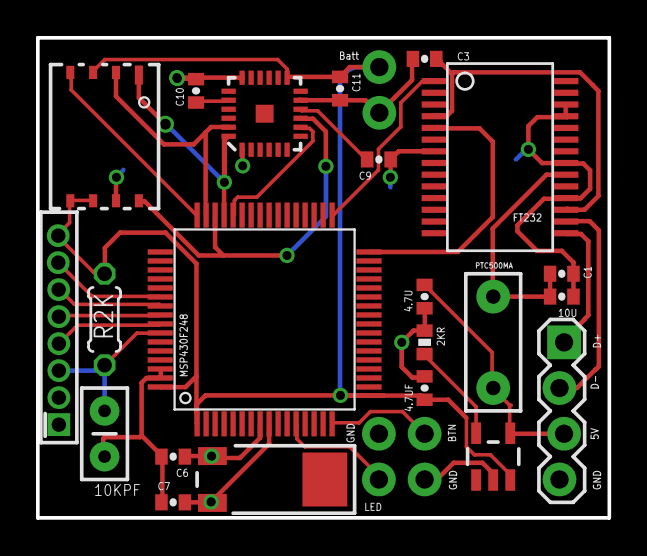
[picture p41: board BC7.brd from above]

Board: 2 copper layers, 31.8 x 26.7 mm, 26 parts (0 on the bottom side), 26 nets.
