iamsurya/MPU6000-Datalogger/(commit log)

2014-04-17 Cleaned Version Reads and Wries to Memory at 15hz
    Need to add reading from memory and sending over uart
2014-04-19 Changed SPI from Port 3 to Port 5
    Having UART on the Same Port would require initializing pins to SPI and
    then to UART back and forth when reading from memory. Avoided this by
    having them on different ports. USCI_Ax is only on P3.
    [main.c]
2014-04-19 Added UART
    Added UART to the device
2014-04-22 Fixed UART sending only first page repeatedly
    [main.c, main.h]
2014-04-28 Multiple Fixes
    Fixed the Address sent to the Dataflash. ( It has to leave the highest
    bit when in 1024 mode).
    Fixed Sending the Time when logging in ASCII.
    Changed from ASCII to Binary Mode logging.
    [main.c, main.h]
2014-04-28 Removed Unwanted Code. Changed UART to 115200 bps.
2014-04-28 Removed delays in SPI fns, moved unwated fn's
    to .h
2014-04-29 Removed extra whitespace. Fixed timer drift.
    [main.c, main.h]
2014-05-01 Changed Button Behaviour
    OFF : Short Button Press: Turn ON
    OFF: Long Press : Reset Page Counter
    ON : Short Press : Do Nothing
    ON : Long Press : Turn OFF
    [main.c, main.h]
2014-05-21 Random Commit
    Will revert after this.
    [main.c]
2014-05-21 Added read device data by UART RX
    Send 's', 'd' to the device for a memory dump.
2015-02-11 Fixing Github Mess up
    [main.c, main.h, mpu6000.h]
2015-03-23 SVS set o 3.05V and Bugfixes
    [main.c, main.h]
2018-02-04 Changing folder layout to add non-code files
    To do:
    Add Eagle PCB files, datasheets, thesis and presentation.
2018-02-04 Added PCB Layout designed using Eagle PCB
    [BC5.brd, BC5.sch, BC7.brd, BC7.sch, Final_Thesis.sch]
2018-02-04 Added datasheets, thesis and presentation pdf
    [BOM.xlsx, SensorComparison.xlsx, SensorsfromSTM.xlsx]
2018-02-04 Image showing final device and parts added
