iamsurya/MPU6000-Datalogger/(notices)

Notices in the files:
parts and their libraries:
SparkFun: Released under the Creative Commons Attribution Share-Alike 3.0 License
SparkFun: http://creativecommons.org/licenses/by-sa/3.0
SparkFun-Connectors: Licensing: CC v3.0 Share-Alike You are welcome to use this library for commercial purposes.
